mcattin/cvora/python/README.txt

# Dependencies:

libvv_pts.so -> /acc/src/dsc/drivers/cohtdrep/lewis/pts/src/lib/vv_pts.L865.so
ptsexcept.py -> /acc/src/dsc/drivers/cohtdrep/lewis/pts/ubuntu/pts/pyts/ptsexcept.py
python -> /acc/src/dsc/drivers/cohtdrep/lewis/pts/ubuntu/pts/2.7.3/bin/python
vv_pts.py -> /acc/src/dsc/drivers/cohtdrep/lewis/pts/ubuntu/pts/pyts/vv_pts.py

# NOTE: The sources and binaries of the vme pts should be placed in a common folder, not in lewis/ folder.
