mcattin/cvora/software/README.txt

# Dependencies :

vmeio.3.2.43-rt63.ko

from: /acc/src/dsc/drivers/cohtdrep/lewis/pts/src/driver/

# NOTE: The sources and binaries of the vmeio should be placed in a common folder, not in lewis/ folder.
