mcattin/cvora/hdl/rtl/Manifest.py

files = [
    "top_cvora.vhd",
    "vme_interface.vhd",
    "bus_interface_pkg.vhd",
    "bus_interface.vhd",
    "rom_mux.vhd",
    "up_down_counter.vhd",
    "rs232_rx.vhd",
    "rs232_tx.vhd",
    "bin2bcd.vhd",
    "ram_manager.vhd",
    "dac_load_delay.vhd",
    "vme_pkg.vhd",
    "message.vhd",
    "message_pkg.vhd",
    "cvora_pkg.vhd",
    "rtm_serial_manager.vhd",
    "sci_decoder.vhd",
    "cvorb_decoder.vhd"]
