mcattin/cvora/(commit log)

2014-02-26 hdl: Work on the registers. Renaming in progress.
    - mode is now 4 bits
    - no default mode with jumpers
    - all fp inputs sync'ed with gc_sync_ffs
    - data from interface controller sampled on rising edge of sys_clk
2014-02-26 hdl: Continue clean-up.
    - simpler pps counter
    - gc_extend_pulse for LED monostable
    - generic up/down counter module
    - clean sci decoder (was P2Serial)
    - add cvrob decoder (from Damien Perrelet BE/RF)
    - more renaming on top level
2014-02-26 hdl: Use STROBE only for parallel data input and sample/store data on CLOCK in all modes.
2014-02-26 pyhton,sw: Add python access class and test programs. Add driver install script and readme file listing dependencies.
2014-02-26 hdl: Fix some comments.
    [top_cvora.vhd]
